gzebrick/WD5ACP-KPA-500-WebPage/CaseSmall.jpg

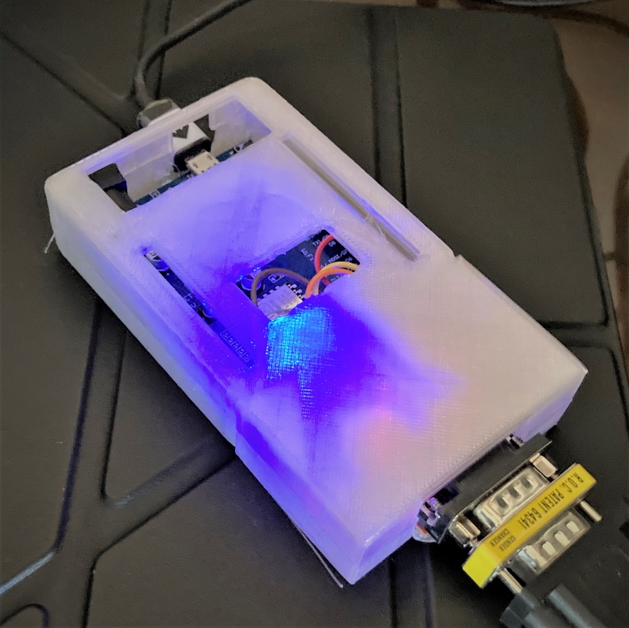
CaseSmall.jpg
