gzebrick/WD5ACP-KPA-500-WebPage/SmallWeMosWiFi.jpg

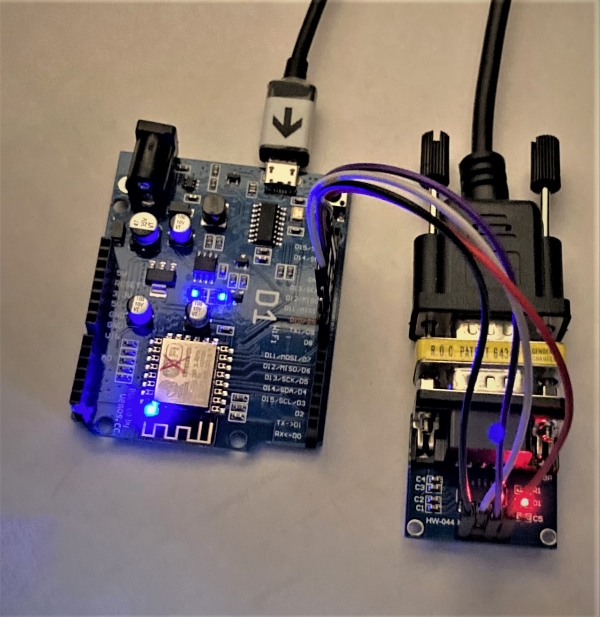
SmallWeMosWiFi.jpg
