gzebrick/WD5ACP-KPA-500-WebPage/KPAv9.05.jpg

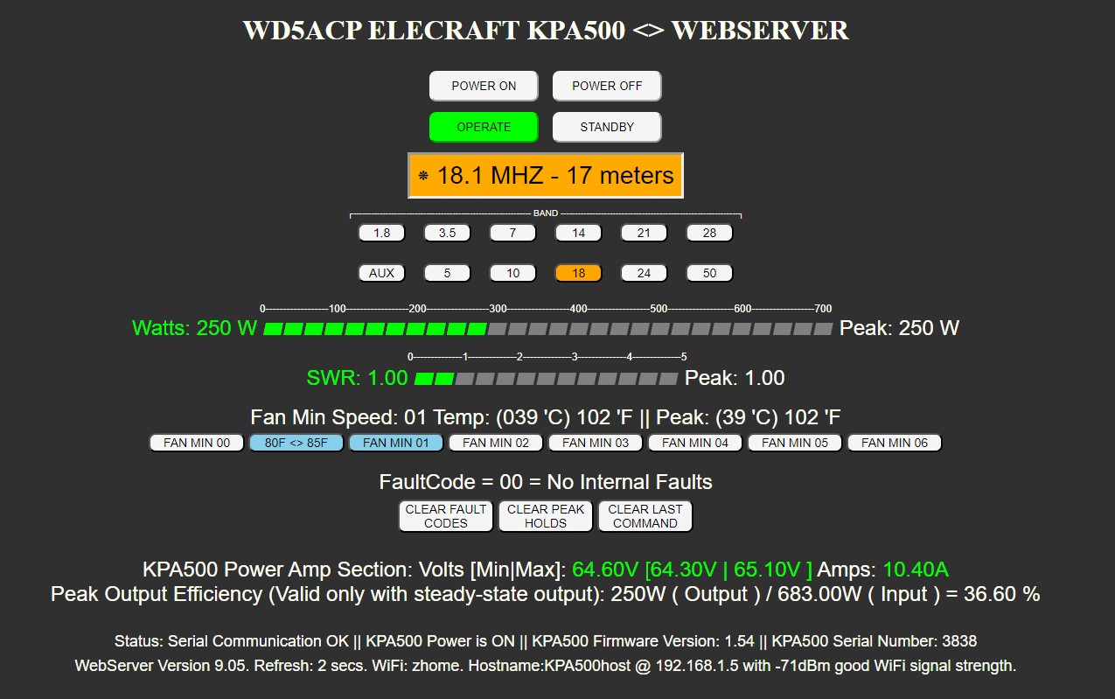
KPAv9.05.jpg
