gzebrick/WD5ACP-KPA-500-WebPage/MediumKpa500.jpg

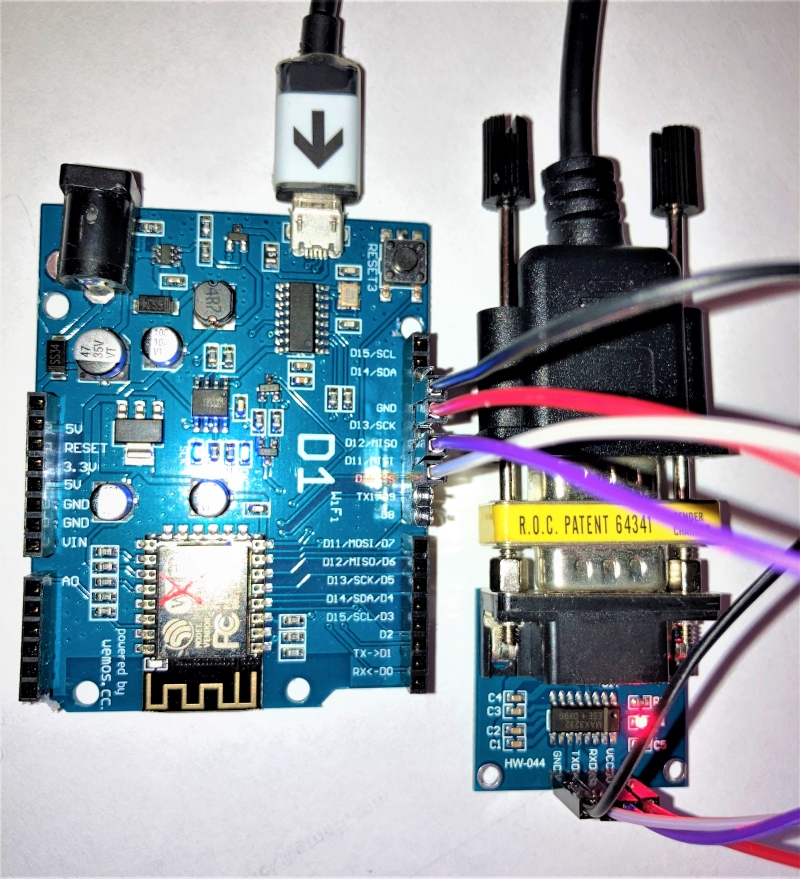
MediumKpa500.jpg
