gzebrick/WD5ACP-KPA-500-WebPage/WD5ACP KPA500.jpg

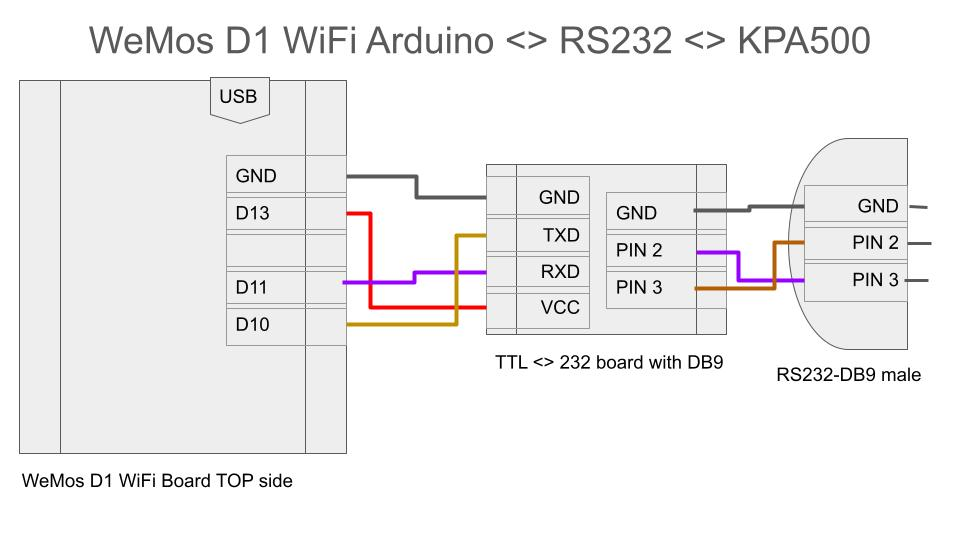
WD5ACP KPA500.jpg
