gzebrick/WD5ACP-KPA-500-WebPage/NetworkSettings.h

// Replace with your network credentials
String mySSID = "zhome2gx";
String myPASS = "";
String myHostName = "KPA500";

// Set your Static IP address (may not be used - see below) ********************************************************
boolean UseStaticIP = true;
IPAddress staticIP(192, 168, 1, 5);
IPAddress gateway(192, 168, 1, 1);
IPAddress subnet(255, 255, 0, 0);
IPAddress pridns(8, 8, 8, 8);  //optional
IPAddress secdns(8, 8, 4, 4);  //optional
