gzebrick/WD5ACP-KPA-500-WebPage/(commit log)

2020-06-25 Add files via upload
    This project was started for use in ham shacks where the mains power to the amplifier (120v/240v) is switched OFF and ON. By design, when MAINs power is applied to the amp (by a separate remote command power switch - Alexa?") , Elecraft designed the amp so it still requires a separate power on command from the physical power button to operate. That's hard to do when you're hundreds of miles away. Alternatively the amp does accept a POWER ON command via it's serial port. The design goal for this project is to make a low-cost web/serial interface to allow the power to be turned on remotely.
    This project is the Arduino code for a low cost all-in-one Arduino ESP8266 WiFi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
2020-07-05 Add files via upload
    Updated version - slight change to colors for POWER and OPERATION MODE (white/grey) and (green/yellow/lightgrey)
2021-02-04 input power peak hold not holding fixed. Clear
2021-02-07 Screen cap ver 2.14
    Changed OPER STBY display to mimic LEDs.
2021-03-01 Photo of WeMos D1 board and TTL<>232 adapter
    WeMos <> 232
    GND ------ GND (black)
    D13 ------- VCC (red Switched 5vdc)
    D12 ------- RX (purple)
    D11 ------- TX (white)
2021-03-02 Web page tweaked
    One line for fan and temp.
    IP shown on bottom status line
2021-03-05 WeMos D1 board & 232
2021-03-06 Simple wiring diagram pin out
2021-03-06 This is the WeMos USB port driver if needed
    I found this on the internet when my Windows 10 laptop stopped seeing the WeMos D1 as a valid com port. For some reason my Windows 10 machine said the USB connection but could not find the driver.
    I inserted the USB cable into the PC and WeMos first, then unzipped and installed this driver.
    Once installed the Arduino programming tool sees the WeMos on a valid com port.
2021-03-06 Picture of 3D case for WeMos board + 232 adapter
2021-03-13 Webpage screen shot
    Shows color display for minimum fan speed command and operating temperature - new to 4.03
2021-03-13 Latest webpage screen capture
    Has color-coded fan minimum buttons
2021-03-14 Latest screen shot with band buttons
2021-03-15 Screenshot with active band buttons
2021-03-17 Screen shot 6.04 button width fixed
2021-07-07 Version 7.00 screenshot with auto switch to standby
2021-09-23 Add files via upload
    Screen shot showing new FAN MIN AUTO button
2021-09-23 New screen shot showing FAN MIN AUTO button
2021-10-01 Screen shot with BAR graphs (and FAN MIN AUTO off)
2024-02-10 Update README.md
    Added links for ESP-12 option + case
